Jamie-Buick/COVID-Clock-In/Images/Block Diagram.png

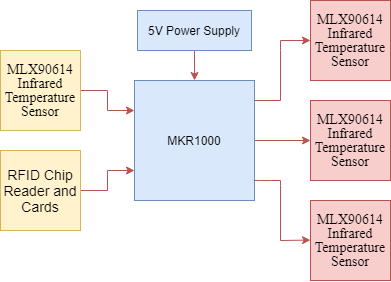
Images/Block Diagram.png
