Jamie-Buick/COVID-Clock-In/Images/Image1.PNG

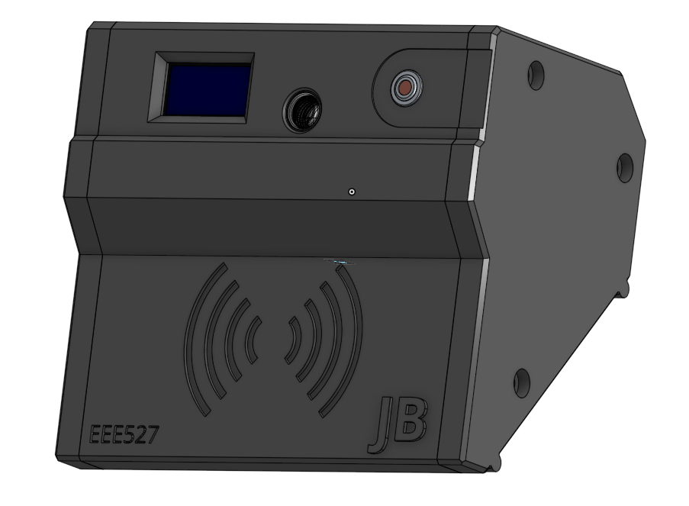
Images/Image1.PNG
