Jamie-Buick/COVID-Clock-In/Images/image2.PNG

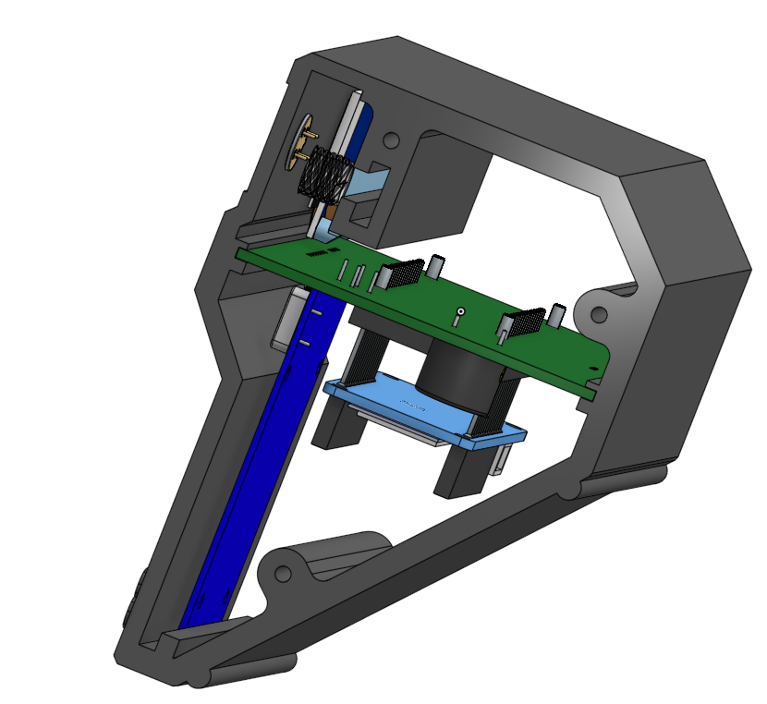
Images/image2.PNG
