Jamie-Buick/COVID-Clock-In/Images/image3.PNG

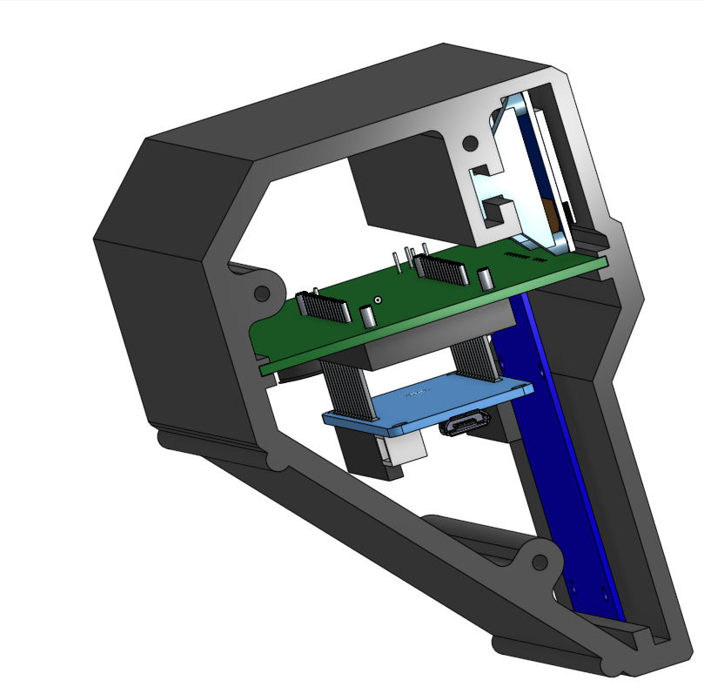
Images/image3.PNG
