Jamie-Buick/COVID-Clock-In/Images/image4.PNG

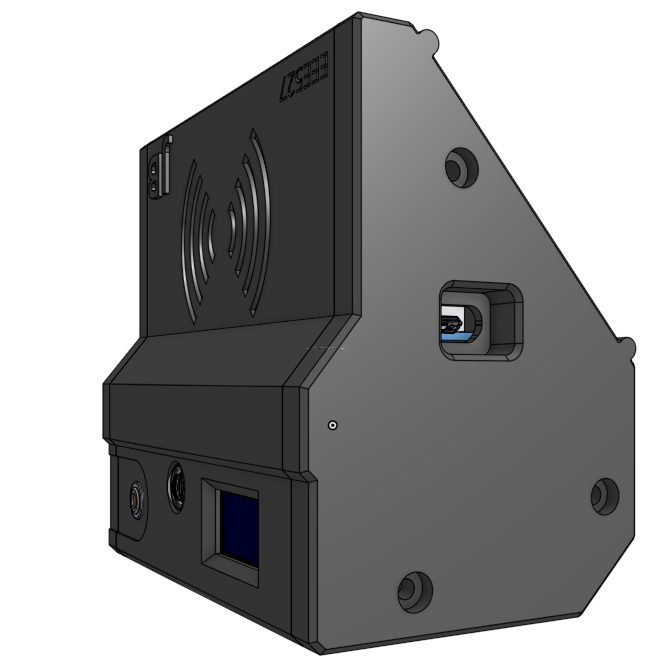
Images/image4.PNG
